t2ofaced/GamePad/BOM.csv

Part Name | Quantity | Link | Info | Price (USD)
JLCPCB PCB Manufacturing & Shipping | 5 | https://jlcpcb.com/ | PCB | $17.75
Micro:bit Edge Connector 40-pin 90 Degree | 1 | https://www.flipkart.com/yellow-tommy-microbit-40-pin-header-90-degree-angle-edge-connector-pack-5-electronic-components-hobby-kit/p/itm9f87dd64a093b | Microbit Edge Connector | $7.43
BBC Microbit V2 | 1 | https://robu.in/product/bbc-micro-bit-v2-pocket-sized-single-board-computer/ | MCU | $22.85
18650 SMD Single Battery Holder | 1 | https://robu.in/product/18650-battery-holder-smd-smt/ | 18650 Battery Holder | $.5
18650 Battery | 1 | https://robu.in/product/dmegc-inr18650-26e-3-7v-2600mah-li-ion-battery/ | Battery | $2.4
TP4056 SMD IC | 1 | https://robu.in/product/1-month-warranty-1253/ | Li-ion Charger IC | $.1
DW01A Battery Protection IC SOT-23-6 | 3 | https://robu.in/product/dw01a-4-3v-lithium-ion-lithium-polymer-battery-protection-ic-6pin-sot-23/ | Battery Protection IC | $.13
FS8205A Dual MOSFET SOT-23-6 | 2 | https://robu.in/product/1-month-warranty-398/ | Dual N-MOSFET | $.18
SPX3819M5-L-3.3 LDO SOT-23-5 | 1 | https://robu.in/product/spx3819m5-l-3-3-tr-500ma-low-noise-ldo-voltage-regulator-5-pin-sot-23/ | 3.3V LDO Regulator | $.24
AO3400A MOSFET SOT-23 | 1 | https://robu.in/product/1-month-warranty-414/ | N-MOSFET | $.11
SMF30A TVS Diode SOD-123FL | 10 | https://robu.in/product/smf30a-slkor-4-1a-48-4v-33-3v-30v-sod-123fl-esd-and-surge-protection-tvs-esd-rohs/ | TVS Diode | $0.1
USB Type-C 16-Pin Female SMD | 1 | https://robu.in/product/type-c-31-m-16-hroparts-1-6p-female-type-c-smd-usb/ | USB-C Port | $0.4
1.8 inch SPI TFT 128x160 ST7735 Display | 1 | https://robu.in/product/62060/ | TFT Display | $3.29
Tactile Push Button 6x6x4.3mm | 7 | https://robu.in/product/6x6x8mm-tactile-push-button-switch-pack-of-20/ | Tactile Switches | $0.15
Slide Switch 3-Pin SPDT 2.54mm | 7 | https://robu.in/product/1-month-warranty-255/ | SPDT Slide Switch | $0.13
0805 SMD LED | 7 | https://robu.in/product/0805-surface-mount-led-green-50-pcs/ | SMD LED | $0.1
100nF 0805 SMD Capacitor | 14 | https://robu.in/product/100nf-0805-surface-mount-multilayer-ceramic-capacitor-pack-of-40/ | 100nF Capacitor | $0.13
10uF 0805 SMD Capacitor | 6 | https://robu.in/product/10uf-10000nf-25-v-capacitor-0805-smd-package-pack-of-10/ | 10uF Capacitor | $0.20
100 Ohm 0805 Resistor | 1 | https://robu.in/product/100-ohm-1-4w-0805-surface-mount-chip-resistor-10-pcs/ | Resistor | $0.11
470 Ohm 0805 Resistor | 5 | https://robu.in/product/rc0805jr-07470kl-yageo-smd-chip-resistor-470-kohm-%C2%B1-5-125-mw-0805-2012-metric-thick-film-general-purpose/ | Resistor | $0.1
1K 0805 Resistor | 4 | https://robu.in/product/1k-ohm-1-4w-0805-surface-mount-chip-resistor-pack-of-10/ | Resistor | $0.1
1.2K 0805 Resistor | 1 | https://robu.in/product/rc0805fr-071k2l-yageo-smd-chip-resistor-1-2-kohm-%C2%B1-1-125-mw-0805-2012-metric-thick-film-general-purpose/ | Resistor | $0.1
5.1K 0805 Resistor | 2 | https://robu.in/product/ac0805fr-075k1l-yageo-res-thick-film-0805-5-1k-ohm-1-0-125w1-8w-%C2%B1100ppm-c-pad-smd-t-r-automotive-aec-q200/ | Resistor | $0.1
10K 0805 Resistor | 2 | https://robu.in/product/rc0805jr-0710kl-yageo-res-thick-film-0805-10k-ohm-5-0-125w1-8w-%C2%B1100ppm-c-pad-smd-t-r/ | Resistor | $0.1
120K 0805 Resistor | 1 | https://robu.in/product/rc0805fr-07120kl-yageo-res-thick-film-0805-120k-ohm-1-0-125w1-8w-%C2%B1100ppm-c-pad-smd-t-r/ | Resistor | $0.1
300K 0805 Resistor | 1 | https://robu.in/product/rc0805fr-07300kl-yageo-res-thick-film-0805-300k-ohm-1-0-125w1-8w-%25c2%25b1100ppm-c-pad-smd-t-r/ | Resistor | $0.1
TOTAL |  |  |  | ~ $64.21
