t2ofaced/GamePad/Production/PCB/GamePad_bom.csv

Designator | Footprint | Quantity | Value | LCSC Part #
BT1 | Keystone_1042_1x18650 | 1 | BK-18650-PC2
C1, C12, C14, C15, C16, C18, C20, C3, C4, C5, C6, C7, C8, C9 | 0805 | 14 | 100nF
C10, C11, C13, C17, C19, C2 | 0805 | 6 | 10uF
D1 | D_SMF | 1 | SMF30A
D2, D3, D4, D5, D6, D7, D8 | 0805 | 7 | LED
J1 | PinHeader_1x08_P2.54mm_Vertical | 1 | TFT Display
J2 | USB_C_Receptacle_HCTL_HC-TYPE-C-16P-01A | 1 | USB_C_
J4 | DONGGUAN_MIC127-140-001 | 1 | MIC127-140-001
Q2 | SOT-23 | 1 | AO3400A
R1, R2 | 0805 | 2 | 5.1K
R10, R4 | 0805 | 2 | 10k
R11 | 0805 | 1 | 120K
R12 | 0805 | 1 | 300K
R13, R14, R15, R16, R17 | 0805 | 5 | 470
R3 | 0805 | 1 | 1000
R5, R6, R9 | 0805 | 3 | 1K
R7 | 0805 | 1 | 1.2K
R8 | 0805 | 1 | 100
SW1 | SW_PUSH_6mm_H4.3mm | 1 | UP
SW2 | SW_PUSH_6mm_H4.3mm | 1 | LEFT
SW3 | SW_PUSH_6mm_H4.3mm | 1 | DOWN
SW4 | SW_PUSH_6mm_H4.3mm | 1 | RIGHT
SW5 | SW_PUSH_6mm_H4.3mm | 1 | MENU
SW6 | SW_PUSH_6mm_H4.3mm | 1 | A
SW7 | SW_PUSH_6mm_H4.3mm | 1 | B
SW8, SW9 | SW_Slide-03_Wuerth-WS-SLTV_10x2.5x6.4_P2.54mm | 2 | SW_SPDT
U1 | SOP-8-1EP_4.57x4.57mm_P1.27mm_EP4.57x4.45mm | 1 | TP4056 | C16581
U2 | SOT-23-6 | 1 | DW01A
U3 | SOT-23-6 | 1 | FS8205 | C32254
U4 | SOT95P280X145-5N | 1 | SPX3819M5-L-3-3
