t2ofaced/GamePad/Production/CAD/Button-Cap.step

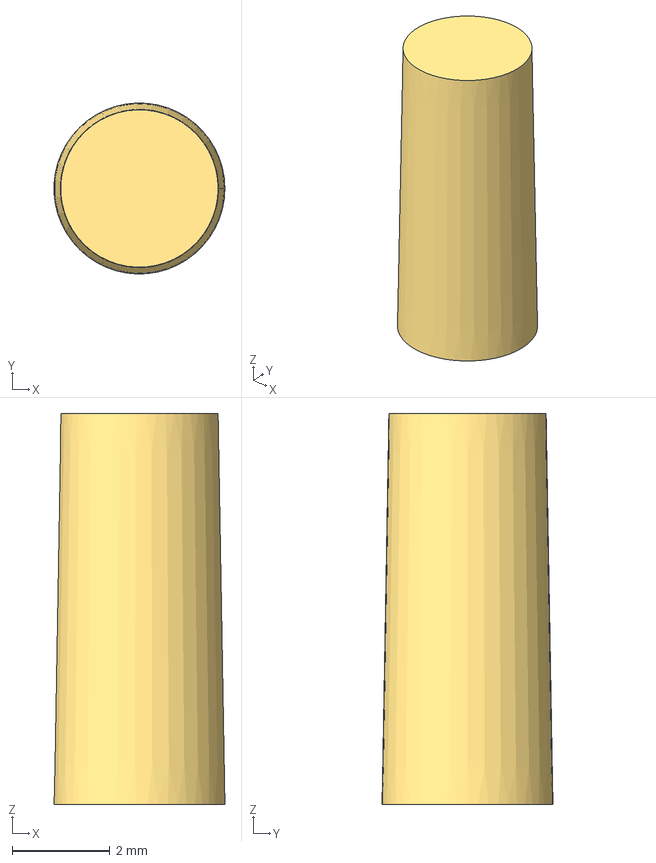
[picture p1: CAD file, 2026-11-04]
Production/CAD/Button-Cap.step
3.50 x 3.50 x 8.00 mm
