t2ofaced/GamePad/Production/CAD/GamePad-Top.step

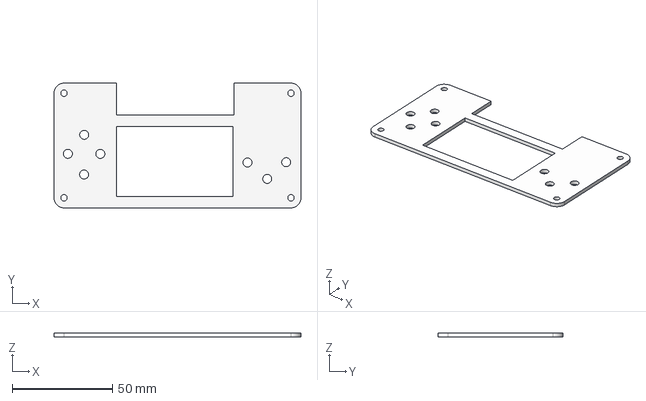
[picture p2: CAD file, 2026-11-04]
Production/CAD/GamePad-Top.step
123.1 x 62.2 x 2.00 mm
