t2ofaced/GamePad/Production/CAD/GamePad-Base.step

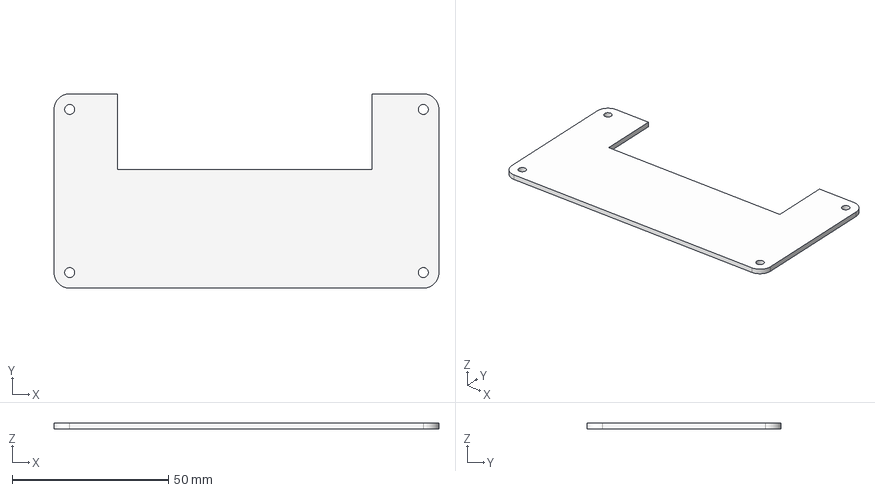
[picture p3: CAD file, 2026-11-04]
Production/CAD/GamePad-Base.step
123.1 x 62.2 x 2.00 mm
