t2ofaced/GamePad/(list of files, cad)

Other CAD files:
Production/CAD/Button-Cap.stl
Production/CAD/GamePad-Base.stl
Production/CAD/GamePad-Top.stl
