t2ofaced/GamePad/PCB/Gamepad.kicad_pcb

## KiCad design PCB/Gamepad.kicad_pcb (2026-11-04)

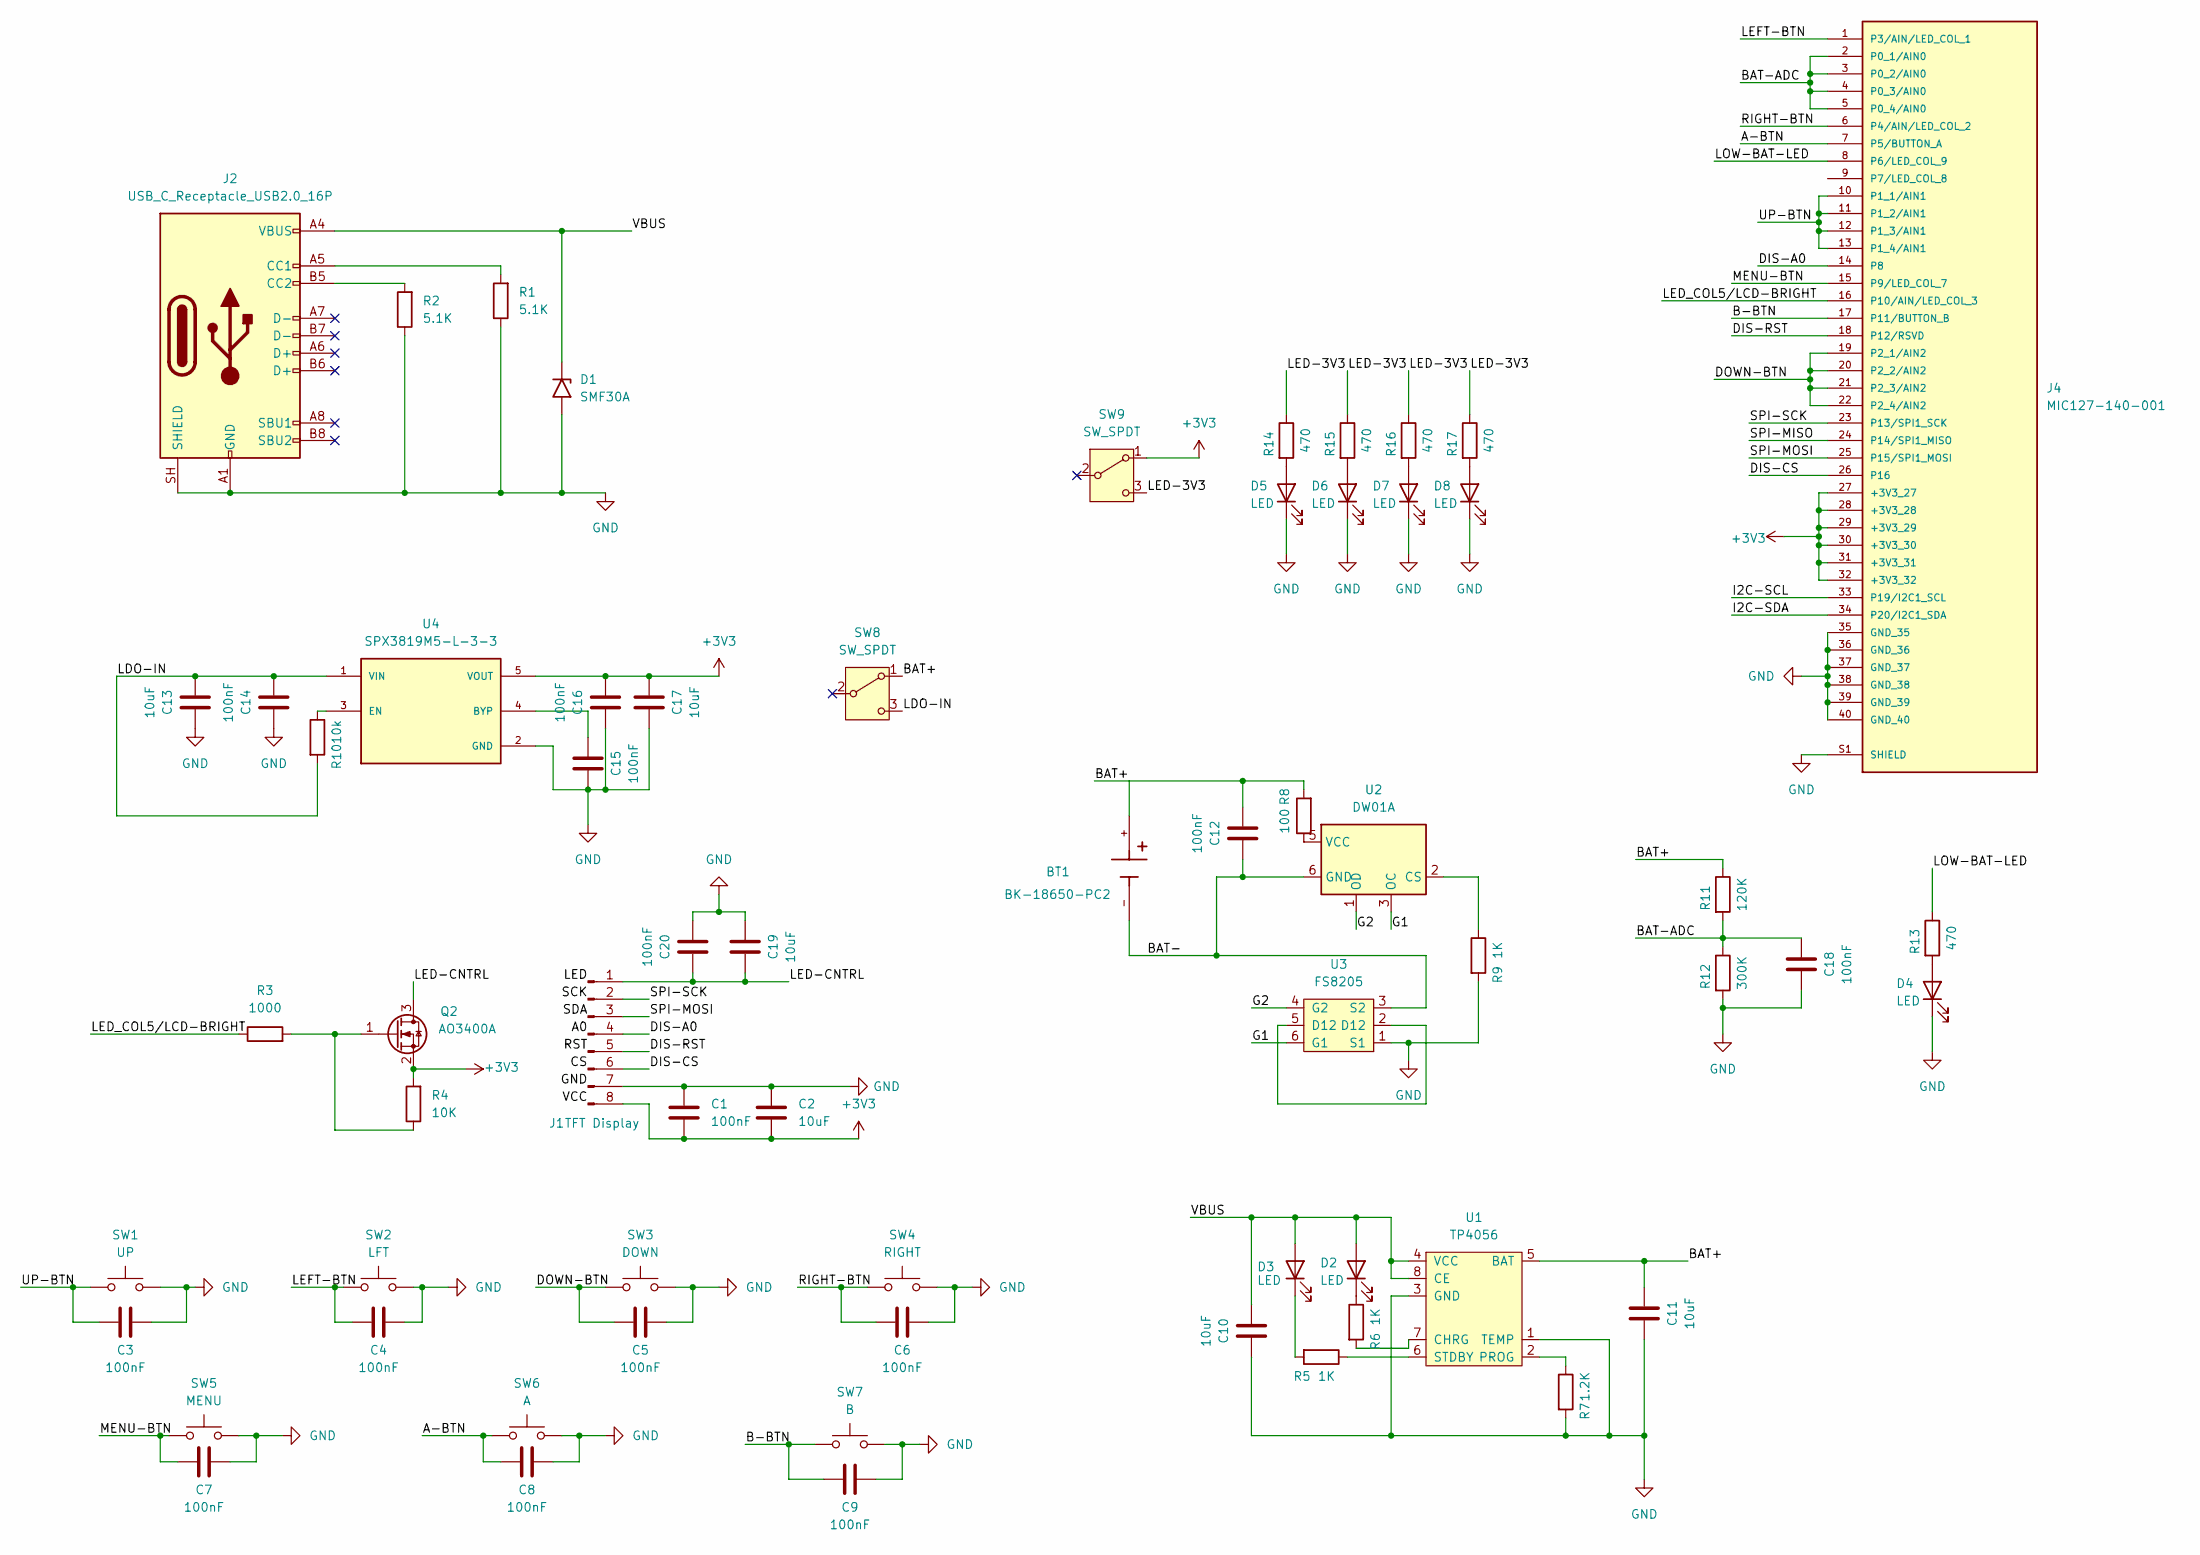
[picture p4: schematic Gamepad.kicad_sch]

Parts:
BT1: BK-18650-PC2; Keystone_1042_1x18650; PARTREV F
C1, C3, C4, C5, C6, C7, C8, C9, C12, C14, C15, C16, C18, C20: 100nF; C_0805_2012Metric
C2, C10, C11, C13, C17, C19: 10uF; C_0805_2012Metric
D1: SMF30A; D_SMF
D2, D3, D4, D5, D6, D7, D8: LED; LED_0805_2012Metric
J1: TFT Display; PinHeader_1x08_P2.54mm_Vertical
J2: USB_C_Receptacle_USB2.0_16P; USB_C_Receptacle_HCTL_HC-TYPE-C-16P-01A
J4: MIC127-140-001; DONGGUAN_MIC127-140-001; PARTREV A
Q2: AO3400A; SOT-23
R1, R2: 5.1K; R_0805_2012Metric
R3: 1000; R_0805_2012Metric
R4: 10K; R_0805_2012Metric
R5, R6, R9: 1K; R_0805_2012Metric
R7: 1.2K; R_0805_2012Metric
R8: 100; R_0805_2012Metric
R10: 10k; R_0805_2012Metric
R11: 120K; R_0805_2012Metric
R12: 300K; R_0805_2012Metric
R13, R14, R15, R16, R17: 470; R_0805_2012Metric
SW1: UP; SW_PUSH_6mm_H4.3mm
SW2: LFT; SW_PUSH_6mm_H4.3mm
SW3: DOWN; SW_PUSH_6mm_H4.3mm
SW4: RIGHT; SW_PUSH_6mm_H4.3mm
SW5: MENU; SW_PUSH_6mm_H4.3mm
SW6: A; SW_PUSH_6mm_H4.3mm
SW7: B; SW_PUSH_6mm_H4.3mm
SW8, SW9: SW_SPDT; SW_Slide-03_Wuerth-WS-SLTV_10x2.5x6.4_P2.54mm
U1: TP4056; SOP-8-1EP_4.57x4.57mm_P1.27mm_EP4.57x4.45mm; LCSC C16581
U2: DW01A; SOT-23-6
U3: FS8205; SOT-23-6; LCSC C32254
U4: SPX3819M5-L-3-3; SOT95P280X145-5N; PARTREV 2.0.5

Connections:
+3V3: C1.2, C2.2, C16.2, C17.1, J1.8, J4.27 (+3V3_27), J4.28 (+3V3_28), J4.29 (+3V3_29), J4.30 (+3V3_30), J4.31 (+3V3_31), J4.32 (+3V3_32), Q2.2 (S), R4.2, SW9.1 (A), U4.5 (VOUT)
/A-BTN: C8.2, J4.7 (P5/BUTTON_A), SW6.1
/B-BTN: C9.2, J4.17 (P11/BUTTON_B), SW7.1
/BAT+: BT1.1, C11.1, C12.2, R8.2, R11.1, SW8.1 (A), U1.5 (BAT)
/BAT-: BT1.2, BT1.-, C12.1, U2.6 (GND), U3.3 (S2)
/BAT-ADC: C18.1, J4.2 (P0_1/AIN0), J4.3 (P0_2/AIN0), J4.4 (P0_3/AIN0), J4.5 (P0_4/AIN0), R11.2, R12.1
/DIS-A0: J1.4, J4.14 (P8)
/DIS-CS: J1.6, J4.26 (P16)
/DIS-RST: J1.5, J4.18 (P12/RSVD)
/DOWN-BTN: C5.2, J4.19 (P2_1/AIN2), J4.20 (P2_2/AIN2), J4.21 (P2_3/AIN2), J4.22 (P2_4/AIN2), SW3.1
/G1: U2.3 (OC), U3.6 (G1)
/G2: U2.1 (OD), U3.4 (G2)
/I2C-SCL: J4.33 (P19/I2C1_SCL)
/I2C-SDA: J4.34 (P20/I2C1_SDA)
/LDO-IN: C13.2, C14.2, R10.2, SW8.3 (C), U4.1 (VIN)
/LED-3V3: R14.1, R15.1, R16.1, R17.1, SW9.3 (C)
/LED-CNTRL: C19.2, C20.1, J1.1, Q2.3 (D)
/LED_COL5/LCD-BRIGHT: J4.16 (P10/AIN/LED_COL_3), R3.1
/LEFT-BTN: C4.2, J4.1 (P3/AIN/LED_COL_1), SW2.1
/LOW-BAT-LED: J4.8 (P6/LED_COL_9), R13.1
/MENU-BTN: C7.2, J4.15 (P9/LED_COL_7), SW5.1
/RIGHT-BTN: C6.2, J4.6 (P4/AIN/LED_COL_2), SW4.1
/SPI-MISO: J4.24 (P14/SPI1_MISO)
/SPI-MOSI: J1.3, J4.25 (P15/SPI1_MOSI)
/SPI-SCK: J1.2, J4.23 (P13/SPI1_SCK)
/UP-BTN: C3.2, J4.10 (P1_1/AIN1), J4.11 (P1_2/AIN1), J4.12 (P1_3/AIN1), J4.13 (P1_4/AIN1), SW1.1
/VBUS: C10.2, D1.1 (A1), D2.2 (A), D3.2 (A), J2.A4 (VBUS), J2.A9 (VBUS), J2.B4 (VBUS), J2.B9 (VBUS), U1.4 (VCC), U1.8 (CE)
GND: C1.1, C2.1, C3.1, C4.1, C5.1, C6.1, C7.1, C8.1, C9.1, C10.1, C11.2, C13.1, C14.1, C15.2, C16.1, C17.2, C18.2, C19.1, C20.2, D1.2 (A2), D4.1 (K), D5.1 (K), D6.1 (K), D7.1 (K), D8.1 (K), J1.7, J2.A1 (GND), J2.A12 (GND), J2.B1 (GND), J2.B12 (GND), J2.SH (SHIELD), J4.35 (GND_35), J4.36 (GND_36), J4.37 (GND_37), J4.38 (GND_38), J4.39 (GND_39), J4.40 (GND_40), J4.S1 (SHIELD), J4.S2 (SHIELD), R1.1, R2.1, R7.2, R9.2, R12.2, SW1.2, SW2.2, SW3.2, SW4.2, SW5.2, SW6.2, SW7.2, U1.1 (TEMP), U1.3 (GND), U3.1 (S1), U4.2 (GND)
unnamed: D2.1 (K), R6.1
unnamed: D3.1 (K), R5.2
unnamed: D4.2 (A), R13.2
unnamed: D5.2 (A), R14.2
unnamed: D6.2 (A), R15.2
unnamed: D7.2 (A), R16.2
unnamed: D8.2 (A), R17.2
unnamed: J2.A5 (CC1), R1.2
unnamed: J2.B5 (CC2), R2.2
unnamed: Q2.1 (G), R3.2, R4.1
unnamed: R6.2, U1.7 (CHRG)
unnamed: R7.1, U1.2 (PROG)
unnamed: R5.1, U1.6 (STDBY)
unnamed: R9.1, U2.2 (CS)
unnamed: R8.1, U2.5 (VCC)
unnamed: U3.2 (D12), U3.5 (D12)
unnamed: C15.1, U4.4 (BYP)
unnamed: R10.1, U4.3 (EN)

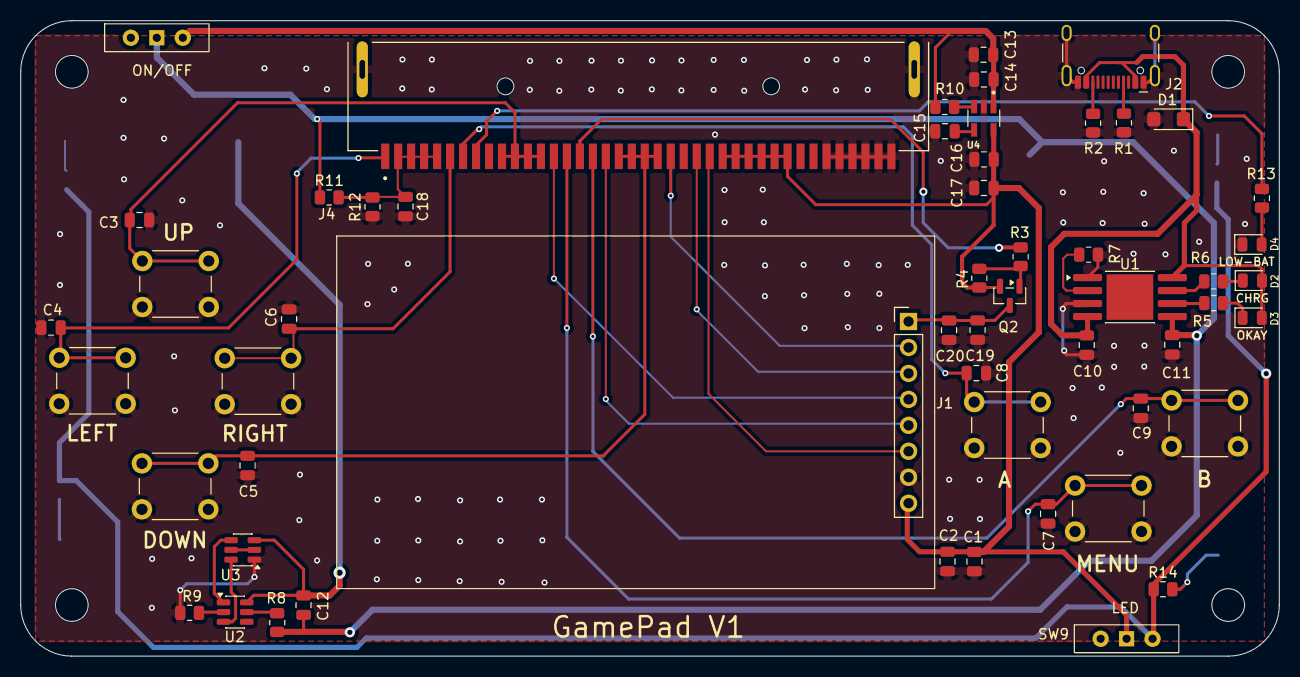
[picture p5: board Gamepad.kicad_pcb from above]

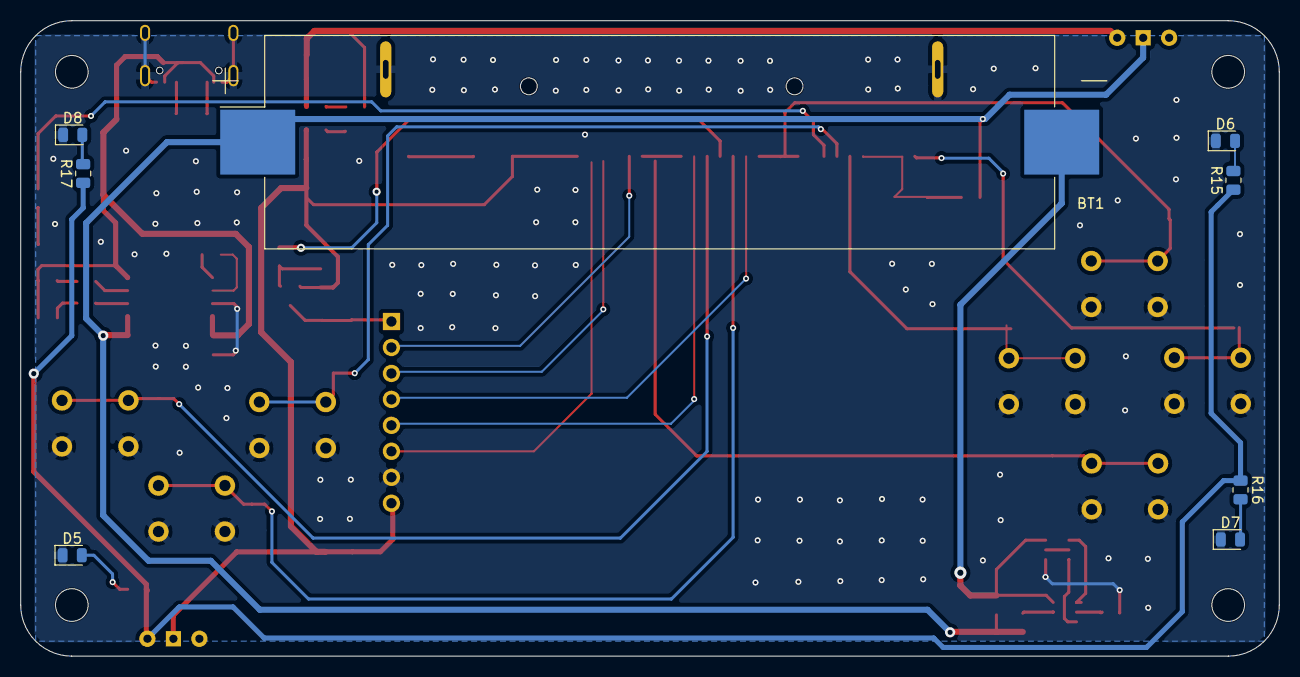
[picture p6: board Gamepad.kicad_pcb from below]

Board: 2 copper layers, 123.1 x 62.2 mm, 63 parts (8 on the bottom side), 43 nets.
