t2ofaced/GamePad/JOURNAL.md

---
title: "Microbit Gamepad"
author: "t2ofaced"
description: "A gamepad for the microbit with a display"
created_at: "2026-09-12"
---

# 06 Nov 2026: Game for Microbit GamePad


well this was kinda hard for me but it is working well

AND


EVIL DUCKYY

**Total time spent: 1 hour 36 minutes**

# 29 Oct 2026: Case design

So i was thinking about case for this gamepad and this is what i thought - 2 transparent acrylic panels one for top and one for bottom




Top plate of the gamepad


bottom plate of the gamepad




top and bottom panels and together


these black cylinders are Hex spacers and the pcb is between them


final view also made these button extenders these are also 3d printable

**Total time spent: 1 hour 8 minutes**

# 11 Oct 2026: Schematic completed, placement and routing


completed schematic and then assigned footprint to the components. I was unable to find the footprint of display so i used a 1X08 male header

After that component placement




and i used the wrong footprint


this is new one

ig they look the same here difference is in schematic


old


New



then started routing


final routing and component placement


poured cu with net label gnd on both top and bottom layer added vias to connect these two layers and added m3 holes


added 3d files of components and exported .step file so that i can make case around it

**Total time spent: 9 hours 14 minutes**

# 29 Sep 2026: LDO, power slider and battery circuit


wired SPX3819M5-L-3-3/TR LDO , bored with ams117 so tried this new ldo and its max op is 500 mA this should work in theory
also added a slider to turn on and off the game pad like it decides whether bat+ goes to ldo or not and u can guess pretty much no input to ldo means no 3v3 and no 3v3 means no led lcd and microbit so board will be off


i add this small circuit left side is a voltage divider which senses the battery voltage level and sends this to a microbit which decides if its low or not and right part is led which glows if battery is low


and these are the led on the back side which will be controlled by a slider this slider connects the 3v3 of board to led 3v3 which connects all the leds

and completed display connections



**Total time spent: 1 hour 29 minutes**

# 12 Sep 2026: Component search and schematic

idk but i am not able to enter log hours anyway

SO i started with component searched finalized some like


perfectly sized and price is also fair good for me

and started schematic i am doing this on kicad as its free

i wired display and type c





in this ses i wired microbit edge connector , also it took me a lot of time to just find right edge connector footprint



and here are the 7 btns of gamepad like 4 for direction up down right left and other 3 are extra function like menu and other function mute maybe not decided yet like they function different with different games type



and this is typical 1 cell charging ic nothing special



protection circuit again standard dw01a ic with fs805, ngl i was confused here these protection circuits are simple but confusing at the same time



**Total time spent: 2 hours 7 minutes**

# 15 Sep 2026: The idea (not on hacktime)

so I wanted to make a offline gamepad for myself from a long time but I never tried for some reason like most diy gamepad I saw were using esp and rpis but today recently i saw something interesting a microbit so now i wanna make a gamepad for microbit and this is inspired by this Gameboy micro but my gamepad gonna be little different in design as well as function



this is close to my imagination my microbit will also mount this on type of edge connector on top side



this is what I am thinking


as u saw I added a display too and I think microbit already have buzzer in it so I don't need that

and yeah most of the microbit gamepads don't include any display



i like this idea because i can flash games in microbit easily then connect it to edge connector of gamepad and enjoy

and i am gonna use 3.7 v bat for power thats it for now ig

**Total time spent: 1 hour**
